TimDangerPowers/Laterne-Pfeil/vorlagen/fenster-vorlage.pdf

# Laterne „Pfeil“ – Schnittvorlage Fensterpapier · Seite 1: Kanzel, Heck, Seiten

Mit 100 % drucken (keine Anpassung an die Seite). Kontrollmaß unten muss genau 100 mm sein. Durchgezogen = schneiden, gestrichelt = falzen (alle Falze zur selben Seite, Papier wird zur Rinne), grau = Fenster dahinter. Kanzel: drei Stücke, sie stoßen auf den beiden Querstreben aneinander (Papier erst

falzen, dann von unten in die Kanzel schieben und am Sims festkleben). Seitenwand: eine für links, eine für rechts.

Kontrollmaß 100 mm

hinten

vorn

# Kanzel hinten (Hellblau)

hinten
vorn

# Kanzel Mitte (Hellblau)

hinten

vorn

# Kanzel vorn (Hellblau)

Trennebene Ober-/Unterschale: hier durchschneiden

oben

# Heckwand (Orange/Gelb)

hinten

vorn

# Seitenwand mit TONI (2 Stück, Orange/Gelb)

hinten

vorn

# Seitenwand mit TONI (2 Stück, Orange/Gelb)

# Laterne „Pfeil“ – Schnittvorlage Fensterpapier · Seite 2: Deck und Bauch

Mit 100 % drucken (keine Anpassung an die Seite). Kontrollmaß unten muss genau 100 mm sein. Durchgezogen = schneiden, gestrichelt = falzen (alle Falze zur selben Seite, Papier wird zur Rinne), grau = Fenster dahinter.

Kontrollmaß 100 mm

Heck | nach vorn

# Deck der Oberschale (Orange/Gelb), hinten x = 0 bis 96 mm

Heck | nach vorn

# Bauch der Unterschale (Orange/Gelb)
