TimDangerPowers/Laterne-Pfeil/bilder/0-ueberblick.png

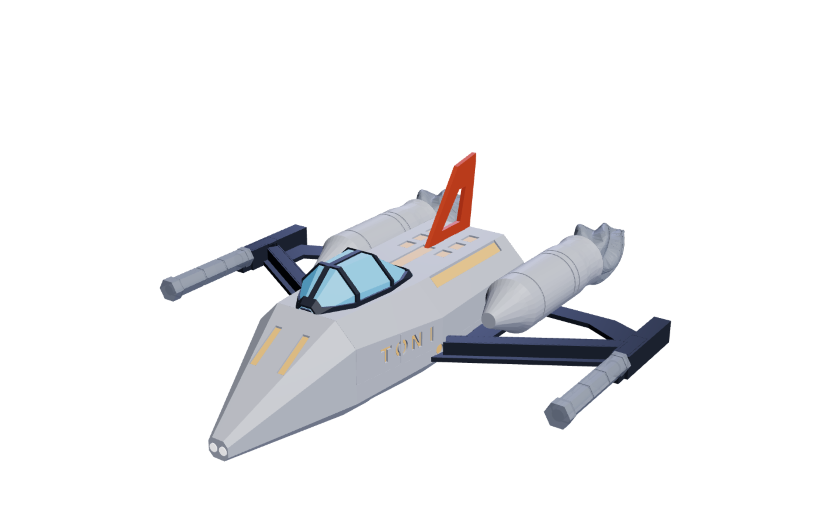
bilder/0-ueberblick.png
