TimDangerPowers/Laterne-Pfeil/bilder/1-tag.png

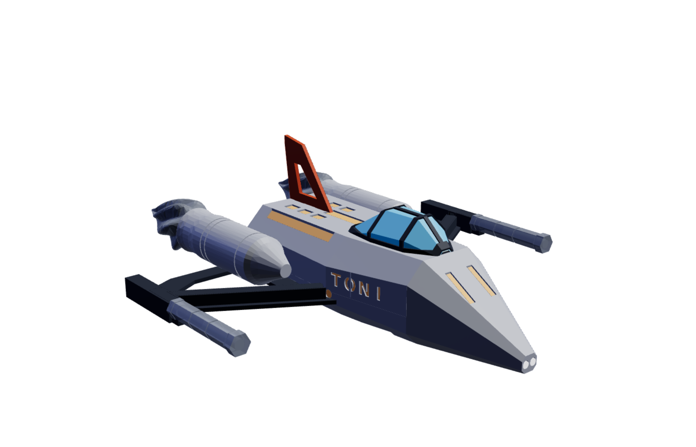
bilder/1-tag.png
