TimDangerPowers/Laterne-Pfeil/bilder/2-nacht.png

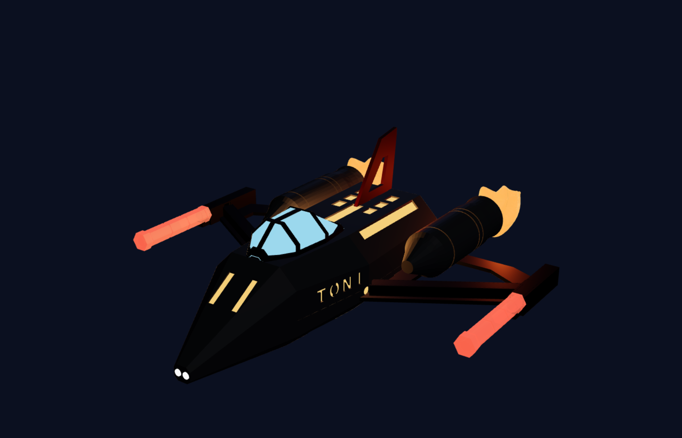
bilder/2-nacht.png
