TimDangerPowers/Laterne-Pfeil/bilder/3-nacht-hinten.png

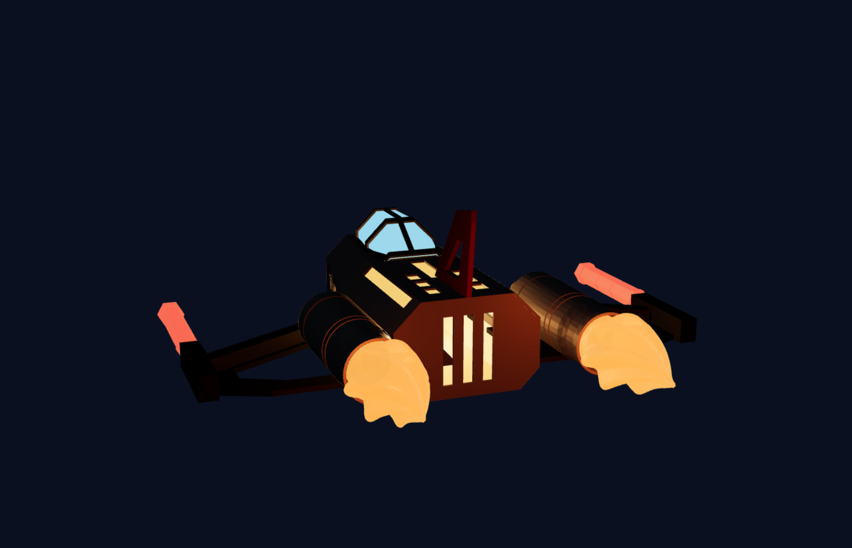
bilder/3-nacht-hinten.png
