TimDangerPowers/Laterne-Pfeil/bilder/4-explosion.png

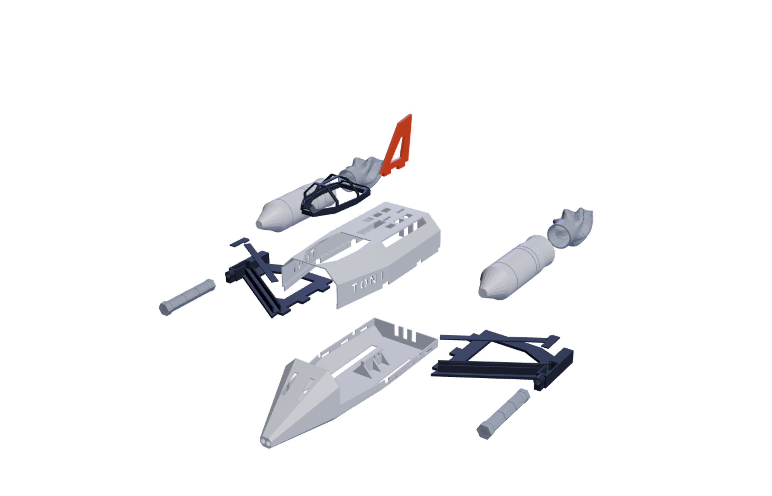
bilder/4-explosion.png
