TimDangerPowers/Laterne-Pfeil/bilder/5-oben.png

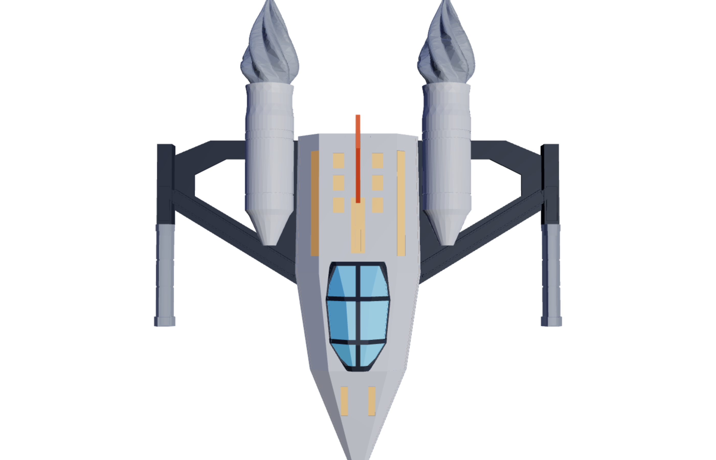
bilder/5-oben.png
