TimDangerPowers/Laterne-Pfeil/bilder/6-seite.png

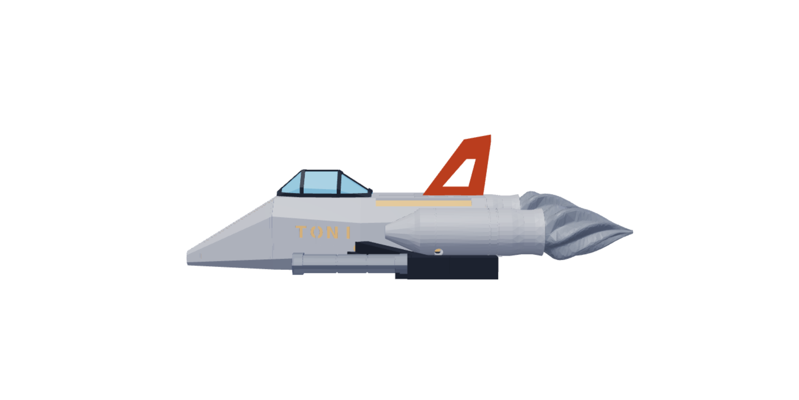
bilder/6-seite.png
