TimDangerPowers/Laterne-Pfeil/bilder/7-griff.png

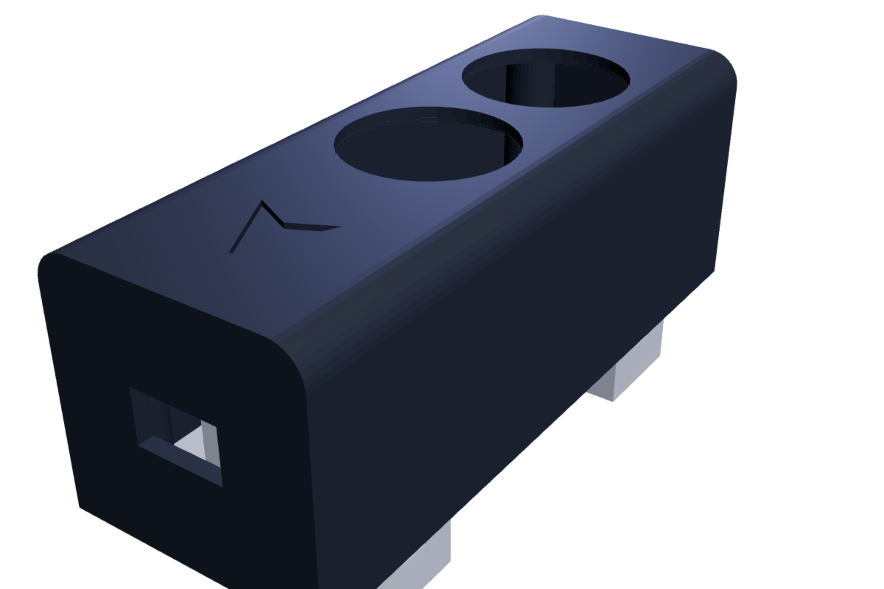
bilder/7-griff.png
