TimDangerPowers/Laterne-Pfeil/bilder/8-fluegel-offen.png

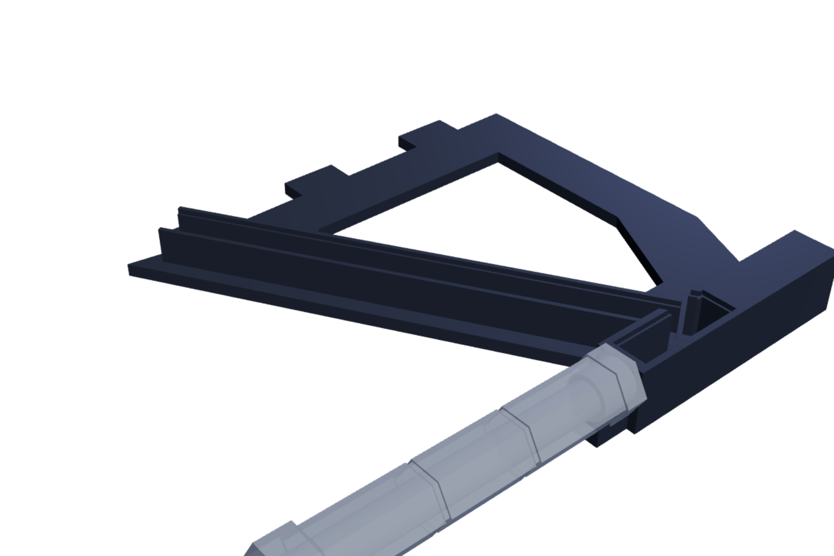
bilder/8-fluegel-offen.png
