TimDangerPowers/Laterne-Pfeil/bilder/check-pfosten.png

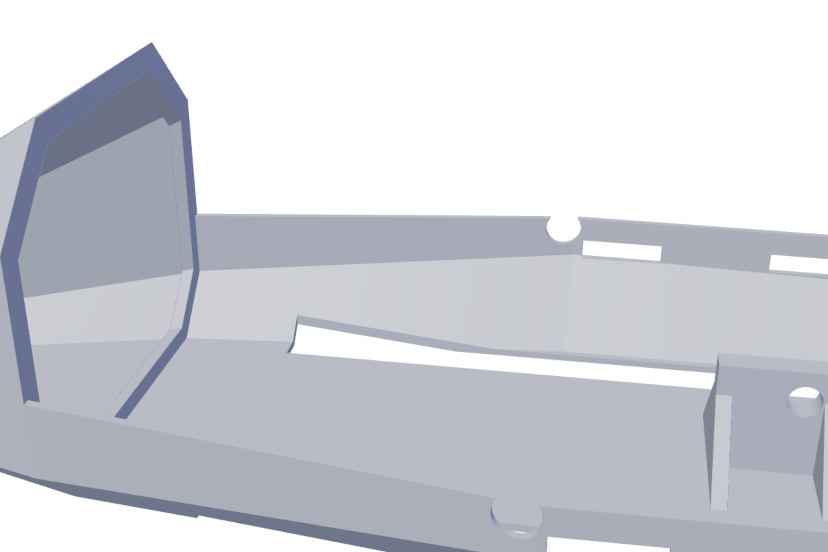
bilder/check-pfosten.png
