TimDangerPowers/Laterne-Pfeil/druck-k2/druck-kanzel.stl

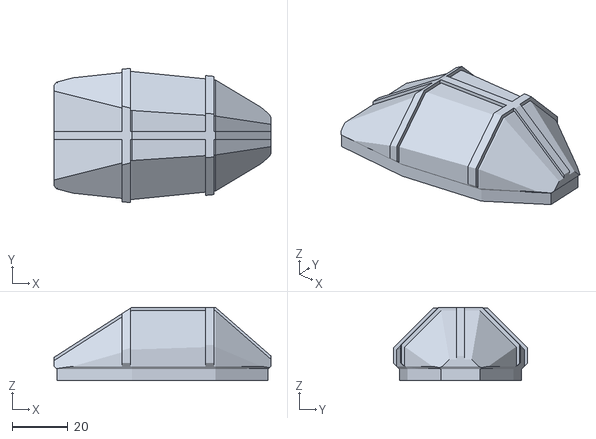
[picture p11: CAD file, 2026-11-08]
druck-k2/druck-kanzel.stl
78.0 x 48.3 x 26.4
