TimDangerPowers/Laterne-Pfeil/druck-k2/druck-flammengitter.stl

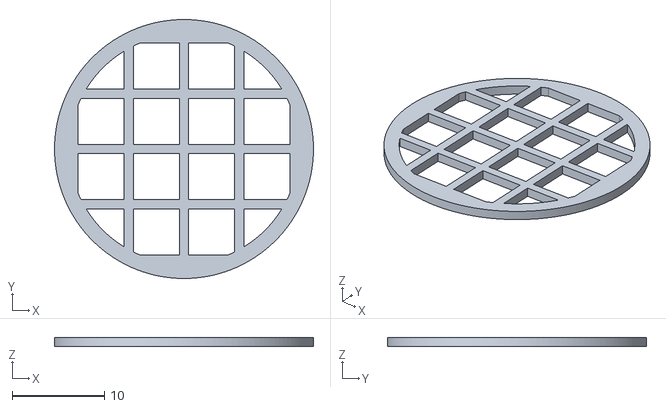
[picture p12: CAD file, 2026-11-08]
druck-k2/druck-flammengitter.stl
28.1 x 28.1 x 1.00
