TimDangerPowers/Laterne-Pfeil/onshape-step/pfeil-jaeger-komplett.step

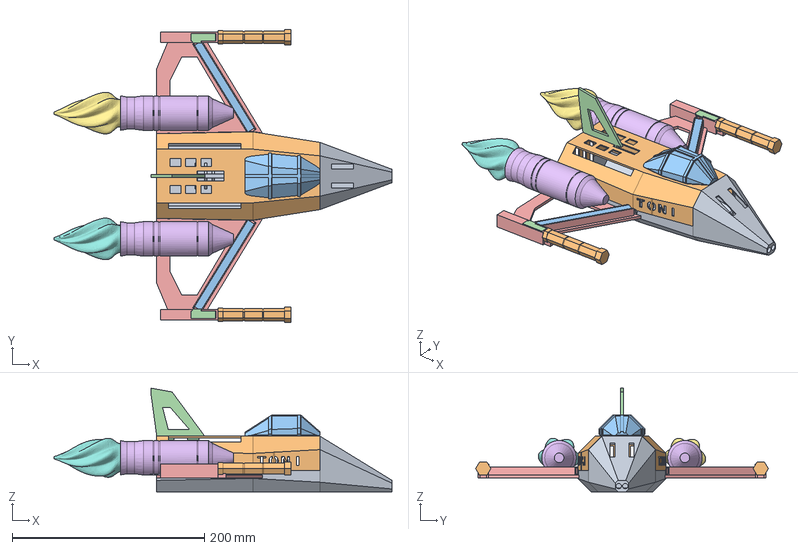
[picture p13: CAD file, 2026-11-08]
onshape-step/pfeil-jaeger-komplett.step
352.0 x 304.8 x 108.0 mm
rumpf-unten
rumpf-oben
kanzel
leitwerk
fluegel-links
fluegel-rechts
triebwerk-links
triebwerk-rechts
flamme-links
flamme-rechts
flammengitter-links
flammengitter-rechts
kanone-links
kanone-rechts
kanaldeckel-links
kanaldeckel-rechts
fussdeckel-links
fussdeckel-rechts
