TimDangerPowers/Laterne-Pfeil/render-modell/flammengitter-rechts.stl

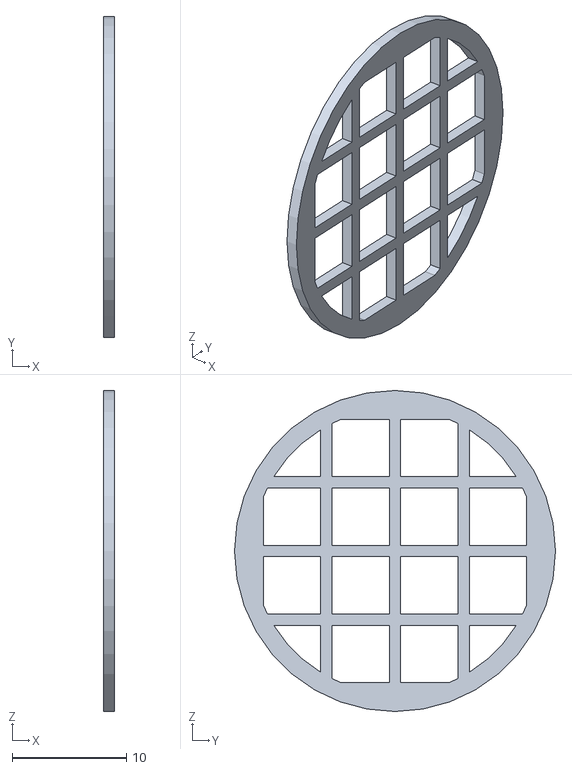
[picture p14: CAD file, 2026-11-08]
render-modell/flammengitter-rechts.stl
1.00 x 28.1 x 28.1
