TimDangerPowers/Laterne-Pfeil/druck-k2/druck-fluegel-links.stl

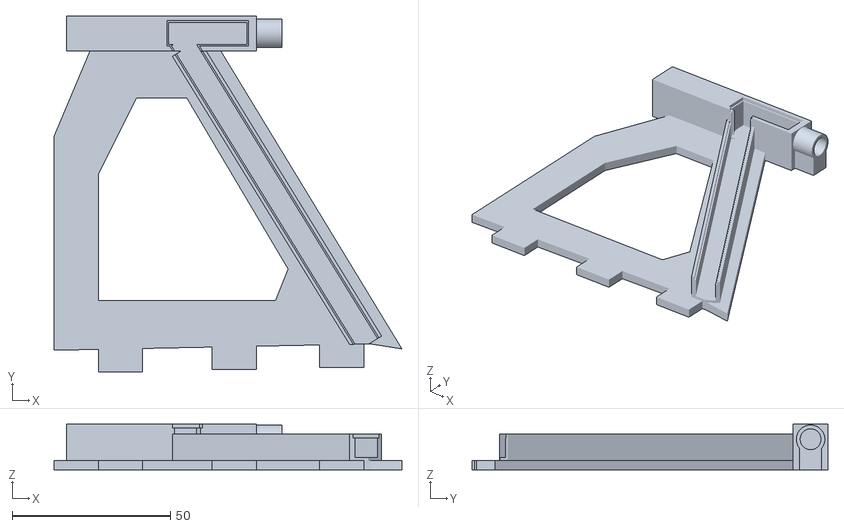
[picture p15: CAD file, 2026-11-08]
druck-k2/druck-fluegel-links.stl
110.0 x 112.6 x 14.5
