TimDangerPowers/Laterne-Pfeil/druck-k2/druck-kanaldeckel-links.stl

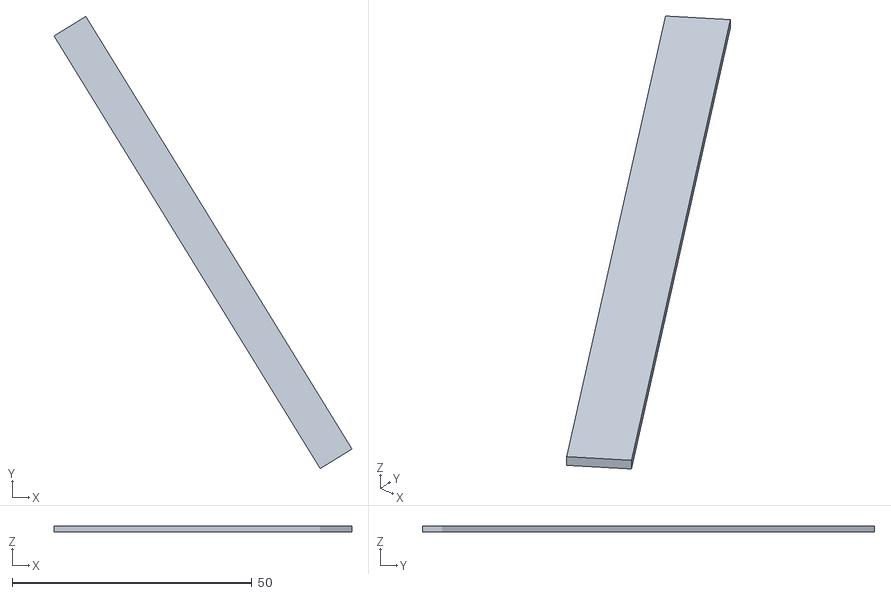
[picture p16: CAD file, 2026-11-08]
druck-k2/druck-kanaldeckel-links.stl
62.2 x 94.4 x 1.20
