TimDangerPowers/Laterne-Pfeil/render-modell/rumpf-oben.stl

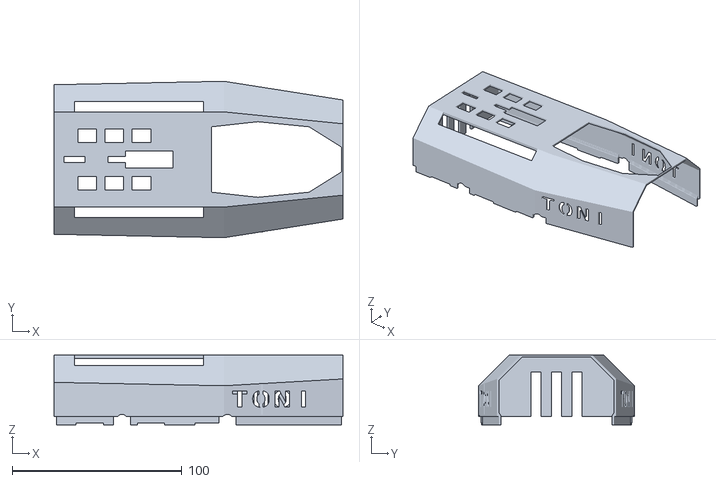
[picture p17: CAD file, 2026-11-08]
render-modell/rumpf-oben.stl
170.0 x 92.0 x 41.0
