TimDangerPowers/Laterne-Pfeil/render-modell/griff.stl

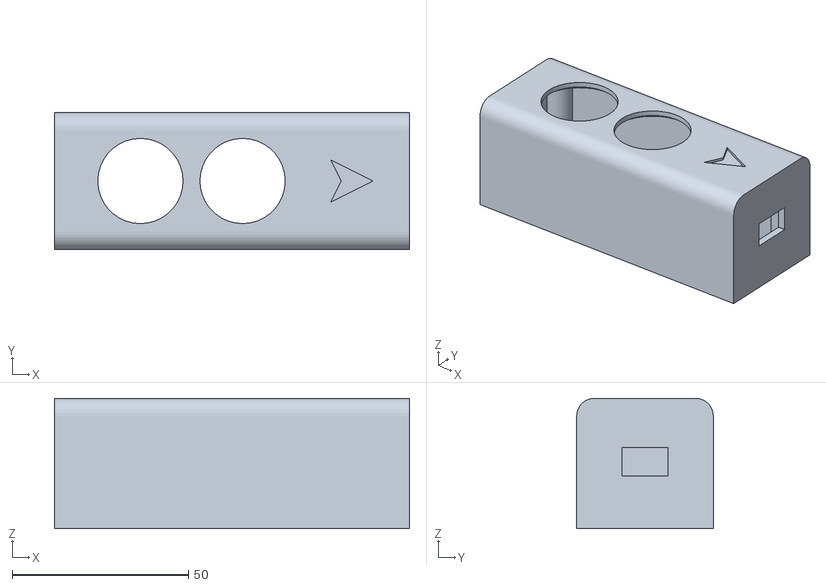
[picture p18: CAD file, 2026-11-08]
render-modell/griff.stl
100.8 x 38.8 x 37.0
