TimDangerPowers/Laterne-Pfeil/druck-k2/druck-kanone.stl

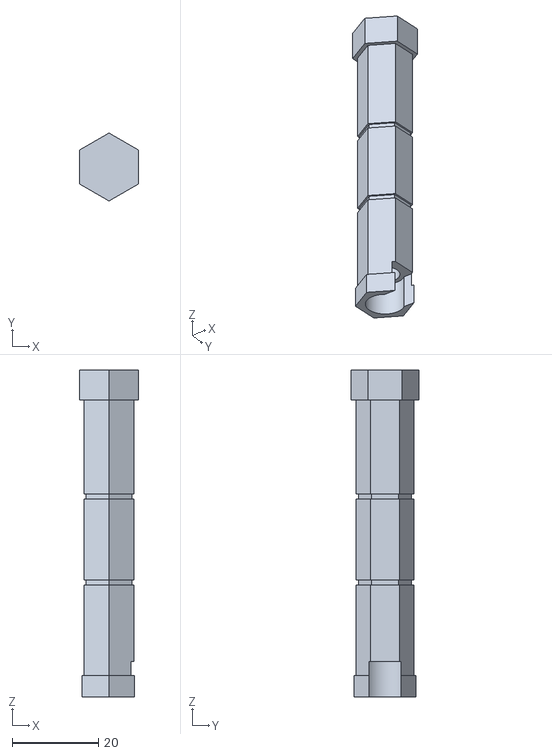
[picture p19: CAD file, 2026-11-08]
druck-k2/druck-kanone.stl
13.7 x 15.8 x 76.0
