TimDangerPowers/Laterne-Pfeil/druck-k2/druck-rumpf-unten.stl

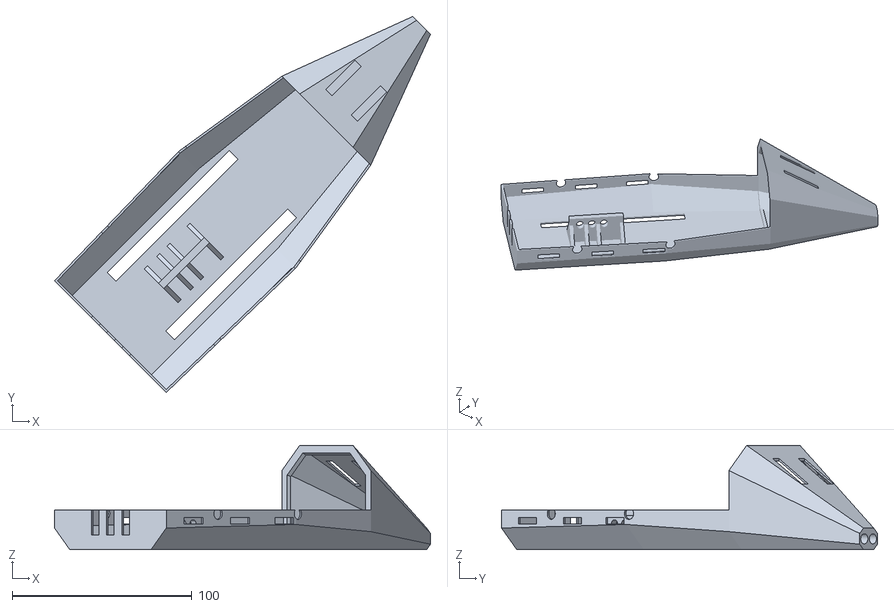
[picture p20: CAD file, 2026-11-08]
druck-k2/druck-rumpf-unten.stl
209.3 x 209.3 x 58.0
