TimDangerPowers/Laterne-Pfeil/druck-k2/druck-leitwerk.stl

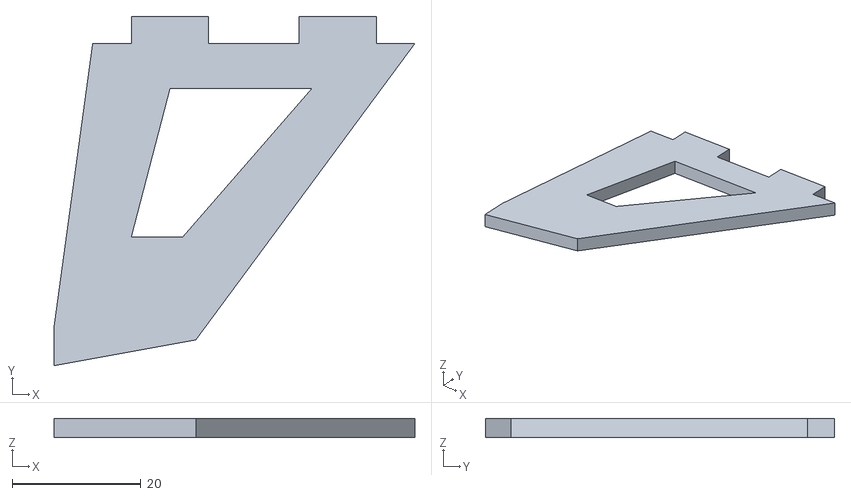
[picture p21: CAD file, 2026-11-07]
druck-k2/druck-leitwerk.stl
56.0 x 54.2 x 3.00
