TimDangerPowers/Laterne-Pfeil/onshape-step/rumpf-unten.step

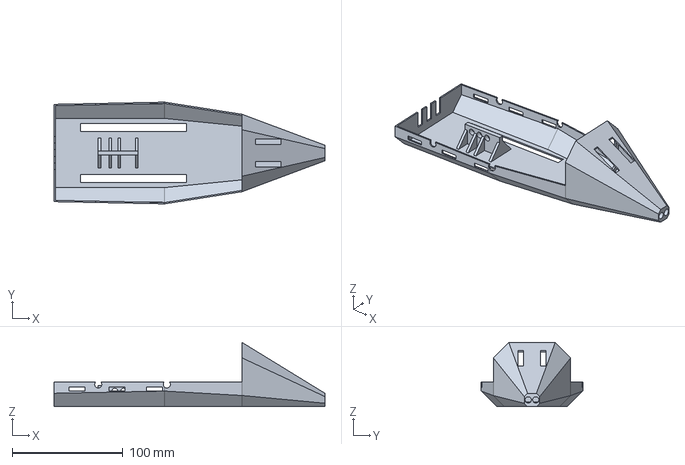
[picture p22: CAD file, 2026-11-08]
onshape-step/rumpf-unten.step
245.0 x 92.0 x 58.0 mm
