TimDangerPowers/Laterne-Pfeil/druck-k2/druck-griff-boden.stl

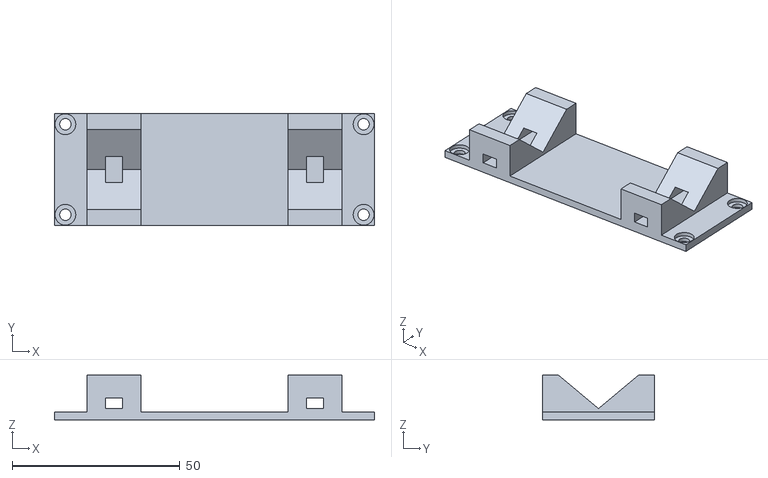
[picture p23: CAD file, 2026-11-07]
druck-k2/druck-griff-boden.stl
95.5 x 33.5 x 13.4
