TimDangerPowers/Laterne-Pfeil/onshape-step/fussdeckel-links.step

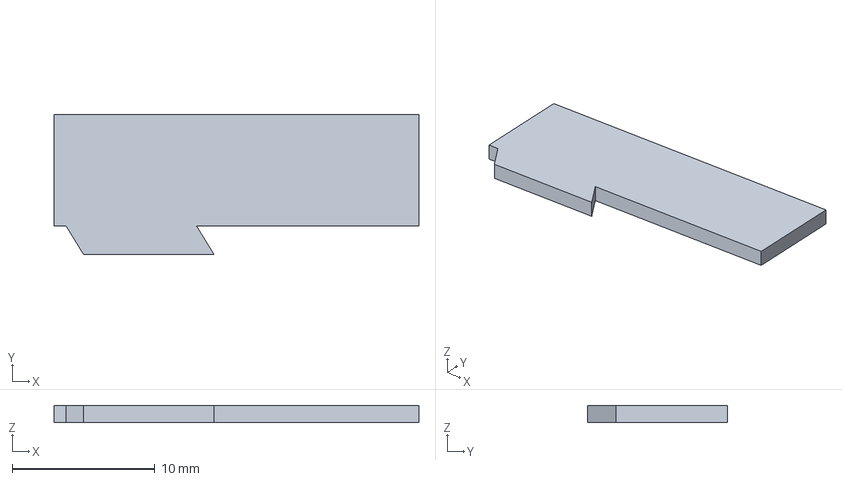
[picture p24: CAD file, 2026-11-07]
onshape-step/fussdeckel-links.step
25.6 x 9.80 x 1.20 mm
