TimDangerPowers/Laterne-Pfeil/onshape-step/griff-bock.step

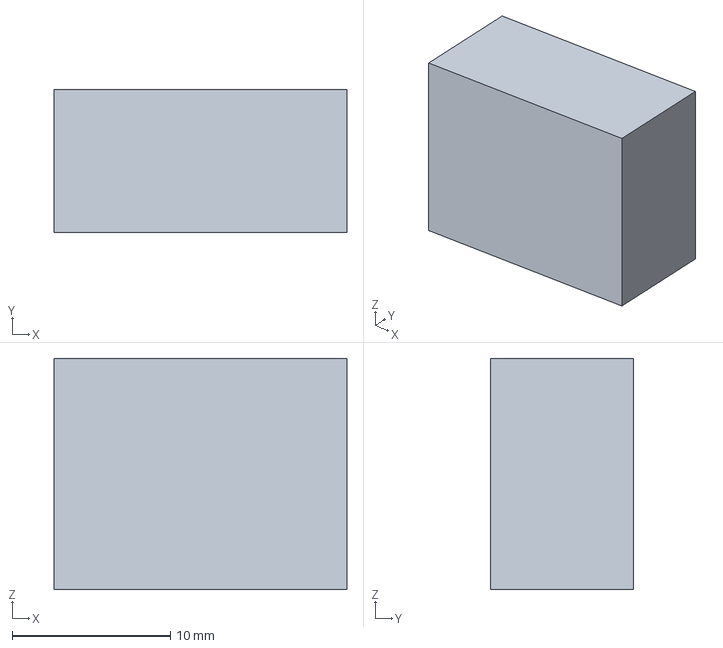
[picture p25: CAD file, 2026-11-07]
onshape-step/griff-bock.step
18.5 x 9.00 x 14.6 mm
