TimDangerPowers/Laterne-Pfeil/render-modell/flamme-links.stl

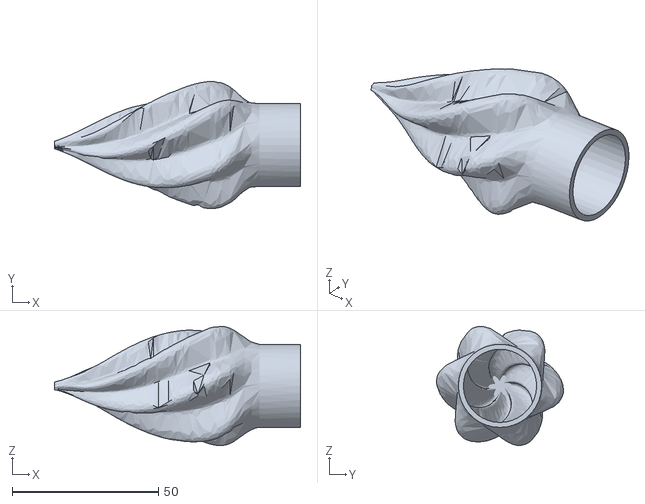
[picture p26: CAD file, 2026-11-07]
render-modell/flamme-links.stl
84.0 x 43.4 x 40.7
