TimDangerPowers/Laterne-Pfeil/druck-k2/druck-triebwerk.stl

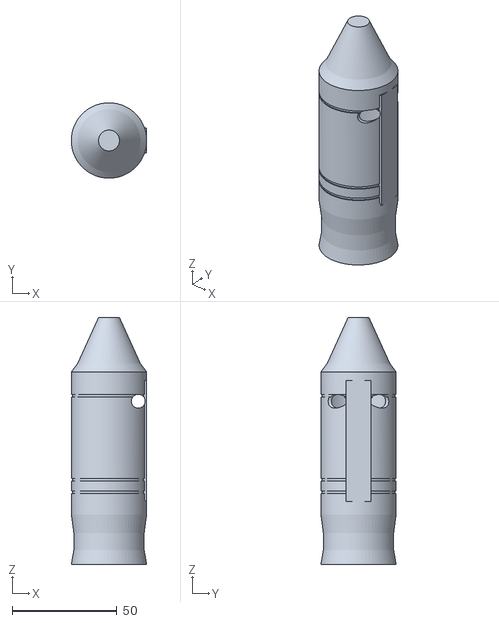
[picture p27: CAD file, 2026-11-07]
druck-k2/druck-triebwerk.stl
36.0 x 36.0 x 118.0
