TimDangerPowers/Laterne-Pfeil/render-modell/papier.stl

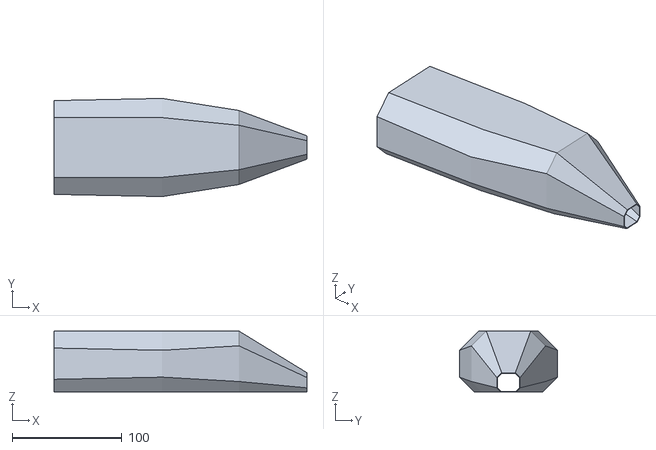
[picture p28: CAD file, 2026-11-07]
render-modell/papier.stl
230.7 x 89.5 x 55.5
