TimDangerPowers/Laterne-Pfeil/render-modell/papier-kanzel.stl

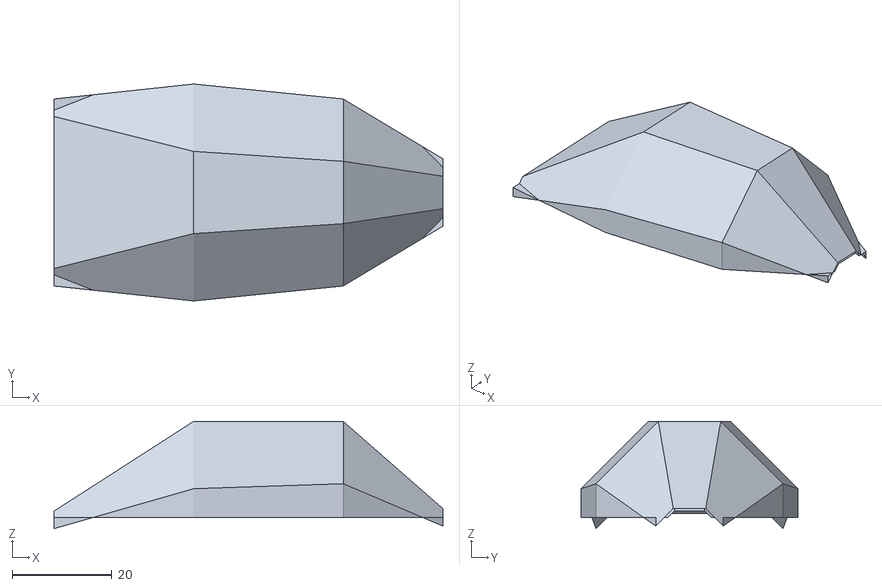
[picture p29: CAD file, 2026-11-07]
render-modell/papier-kanzel.stl
78.0 x 43.5 x 21.5
