TimDangerPowers/Laterne-Pfeil/render-modell/scheinwerfer.stl

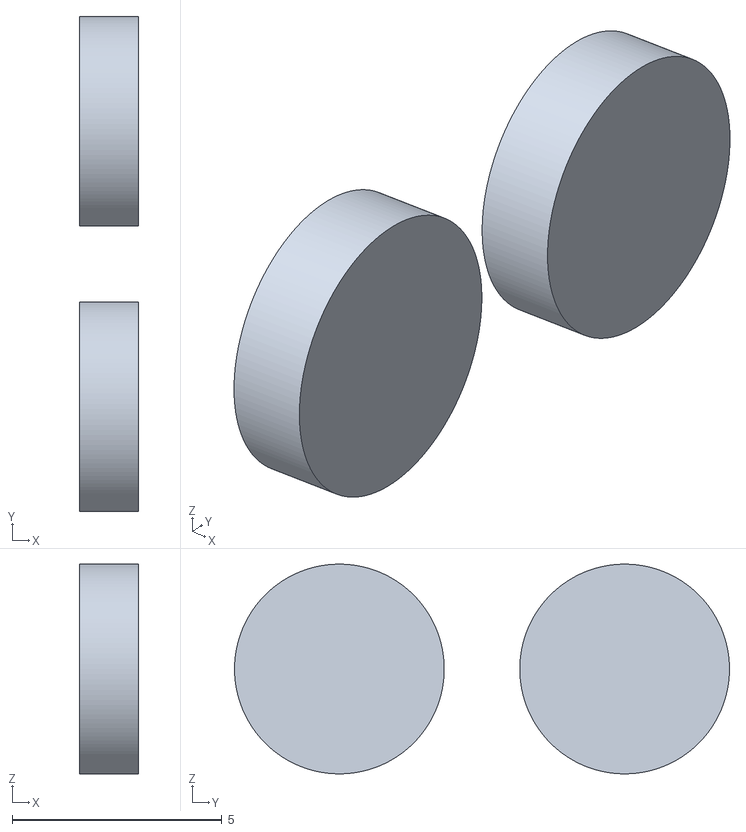
[picture p30: CAD file, 2026-11-07]
render-modell/scheinwerfer.stl
1.40 x 11.8 x 5.00
