TimDangerPowers/Laterne-Pfeil/(list of files, cad)

Other CAD files:
onshape-step/kanzel.step
render-modell/kanzel.stl
onshape-step/flammengitter.step
render-modell/flammengitter-links.stl
onshape-step/fluegel-rechts.step
render-modell/kanaldeckel-links.stl
druck-k2/druck-fluegel-rechts.stl
onshape-step/fluegel-links.step
druck-k2/druck-rumpf-oben.stl
onshape-step/kanaldeckel-rechts.step
druck-k2/druck-kanaldeckel-rechts.stl
onshape-step/rumpf-oben.step
render-modell/fluegel-rechts.stl
druck-k2/druck-griff.stl
onshape-step/griff.step
render-modell/fluegel-links.stl
onshape-step/kanaldeckel-links.step
render-modell/kanaldeckel-rechts.stl
onshape-step/kanone.step
render-modell/kanone-links.stl
render-modell/kanone-rechts.stl
render-modell/rumpf-unten.stl
druck-k2/druck-fussdeckel-links.stl
onshape-step/triebwerk.step
render-modell/griff-bock.stl
druck-k2/druck-fussdeckel-rechts.stl
onshape-step/griff-boden.step
render-modell/triebwerk-rechts.stl
druck-k2/druck-griff-bock.stl
onshape-step/fussdeckel-rechts.step
render-modell/flamme-rechts.stl
druck-k2/druck-flamme.stl
onshape-step/flamme.step
render-modell/fussdeckel-rechts.stl
onshape-step/leitwerk.step
render-modell/triebwerk-links.stl
render-modell/fussdeckel-links.stl
render-modell/griff-boden.stl
render-modell/leitwerk.stl
