TimDangerPowers/Laterne-Pfeil/(commit log)

2026-11-07 Laterne Pfeil: Druckdateien, Anleitung, Elektronik und Firmware-Ordner
    Claude-Session: https://claude.ai/code/session_01TVU3zyi9RxJyen3rUgDVnC
    [druck-flamme.stl, druck-fluegel-links.stl, druck-fluegel-rechts.stl, druck-fussdeckel-links.stl, druck-fussdeckel-rechts.stl, druck-griff-bock.stl, druck-griff-boden.stl, druck-griff.stl]
2026-11-07 Sketch: String-Variablen nur auf ESP32
    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
2026-11-07 Sketch: WLAN-Ergebnis in der Statuszeile anzeigen
    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
2026-11-07 Firmware 3.0: Einstellseite im Browser (LED-Zuordnung, Farben, Helligkeit), eigenes WLAN unterwegs
    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
2026-11-07 Sketch: Prototypen für readBtn/zustandSetzen (Arduino-Prototypen kommen sonst vor den Typen)
    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
2026-11-07 Firmware 3.1: WLAN 20 s warten und alle 2 Minuten neu versuchen
    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
2026-11-08 Unterschale: Bauchfenster bleiben in der flachen Bodenplatte (freistehender Splitter vorn entfernt)
    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
    [druck-rumpf-unten.stl, rumpf-unten.step, rumpf-unten.stl]
2026-11-08 GitHub Actions baut die Firmware automatisch
    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
2026-11-08 Doku: Firmware wird automatisch gebaut
    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
2026-11-08 Schnittvorlage für das Fensterpapier (PDF 1:1)
    Kanzel, Deck, Seitenwände, Heck und Bauch aus dem Modell abgewickelt; Kanzel in drei Stücke zwischen den Querstreben.
    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
2026-11-08 Flammenhalter: Hülse mit Gitterplatte für die zwei LEDs in der Flamme
    Steckt im Kragen der Flamme, zwei Rinnen für die LED-Kapseln, vier Spitzbogenfenster, druckt ohne Stützen.
    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
    [druck-flammenhalter.stl, flammenhalter-links.stl, flammenhalter-rechts.stl, flammenhalter.step, pfeil-jaeger-komplett.step]
2026-11-08 Kanone: Schlitz im Rohrfuß für den Sockel unter dem Zapfen
    Ohne den Schlitz passte das Rohr nicht über den Zapfen des Flügels.
    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
    [druck-kanone.stl, kanone-links.stl, kanone-rechts.stl, kanone.step]
2026-11-08 Passungsprüfung: Kragen über Laschen, Kanalende, Schraubdome, Kanaldeckel
    Alle Teilepaare im Modell auf Überschneidung geprüft; vier Stellen korrigiert, Anleitung mit Hinweisen für schon gedruckte Teile.
    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
    [druck-fluegel-links.stl, druck-fluegel-rechts.stl, druck-griff.stl, druck-kanaldeckel-links.stl, druck-kanaldeckel-rechts.stl, druck-rumpf-oben.stl, fluegel-links.step, fluegel-links.stl]
2026-11-08 Flammenhalter: zwei breite Schlitze statt Gitter, LED mit Draht passt durch
    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
    [druck-flammenhalter.stl, flammenhalter-links.stl, flammenhalter-rechts.stl, flammenhalter.step]
2026-11-08 Flammengitter: dünne Gitterscheibe aufs Kragenende statt Hülse
    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
    [druck-flammengitter.stl, druck-flammenhalter.stl, flammengitter-links.stl, flammengitter-rechts.stl, flammengitter.step, flammenhalter-links.stl, flammenhalter-rechts.stl, flammenhalter.step]
2026-11-08 Firmware 3.6: Helligkeit je Bereich auf der Einstellseite
    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
2026-11-08 Kanzel als geschlossene transparente Haube, Firmware 3.7 mit eigener Schussfarbe
    Kanzel: kein Papier mehr, Streben außen, Innendecke vorn/hinten 45°, druckt ohne Stützen.
    Firmware: Kanonen-Glimmen und Schuss getrennt einstellbar.
    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
    [druck-kanzel.stl, kanzel.step, kanzel.stl, pfeil-jaeger-komplett.step]
